zzdevxx/esp32-artnet-dmx/images/10_solder_wire_tin.png

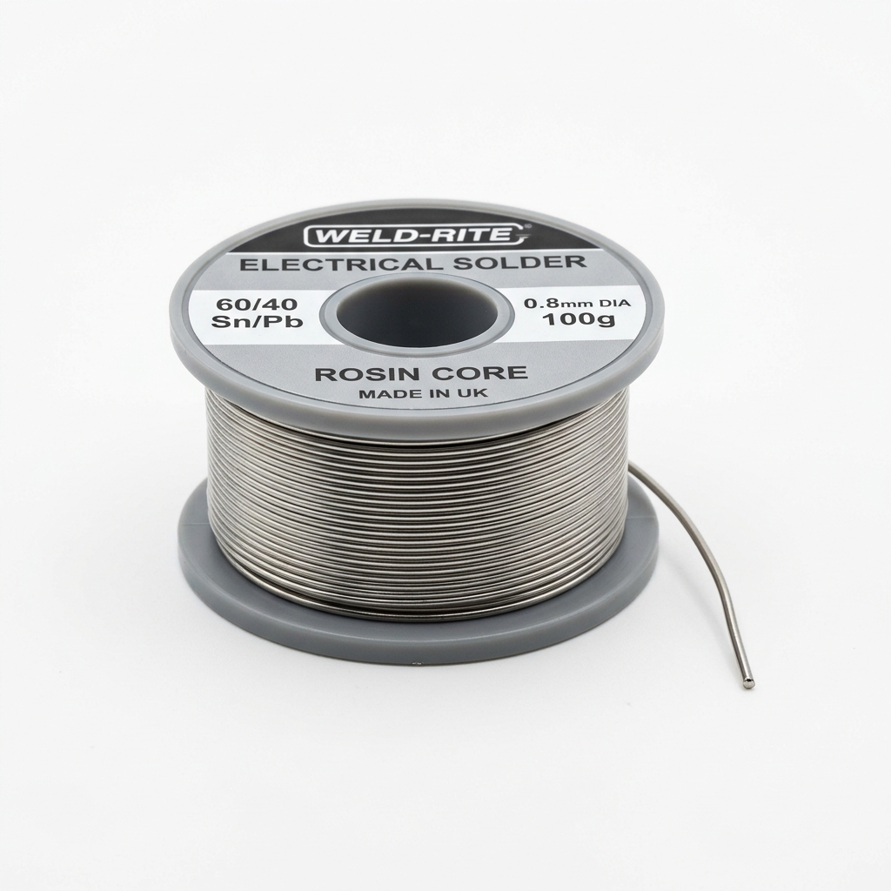
images/10_solder_wire_tin.png
