zzdevxx/esp32-artnet-dmx/RESULT.png

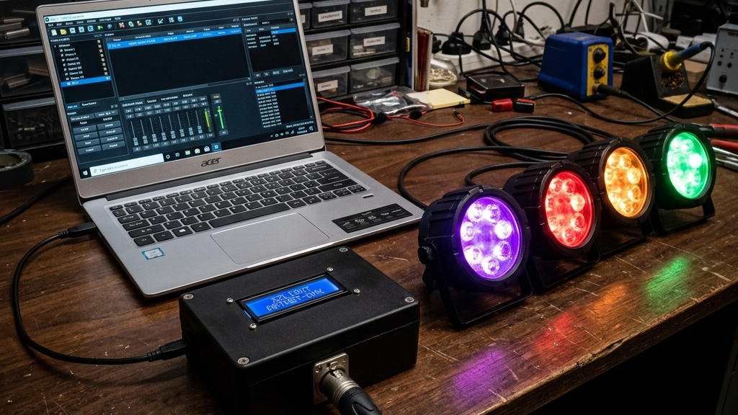
RESULT.png
