zzdevxx/esp32-artnet-dmx/docs/box+rangkaian_01.jpeg

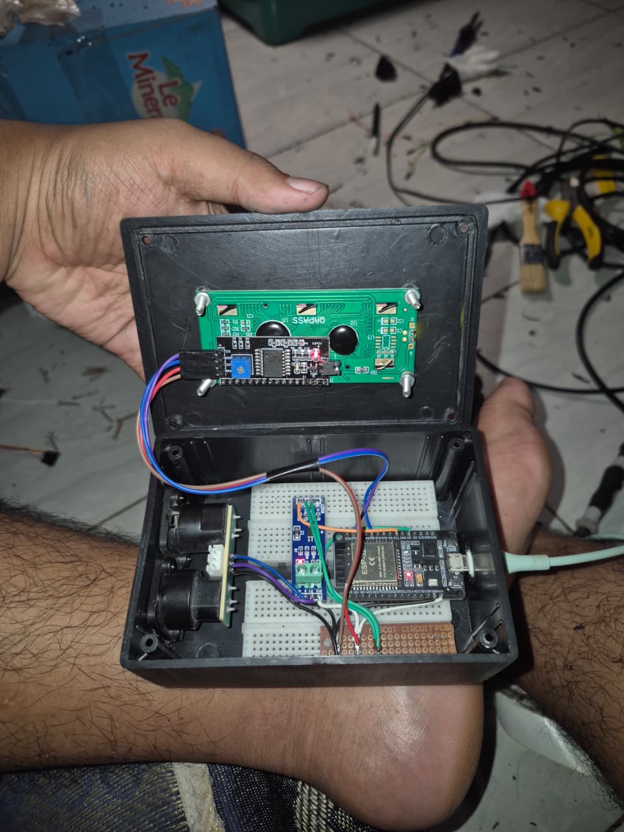
docs/box+rangkaian_01.jpeg
