zzdevxx/esp32-artnet-dmx/docs/box_x4_dibuka.jpeg

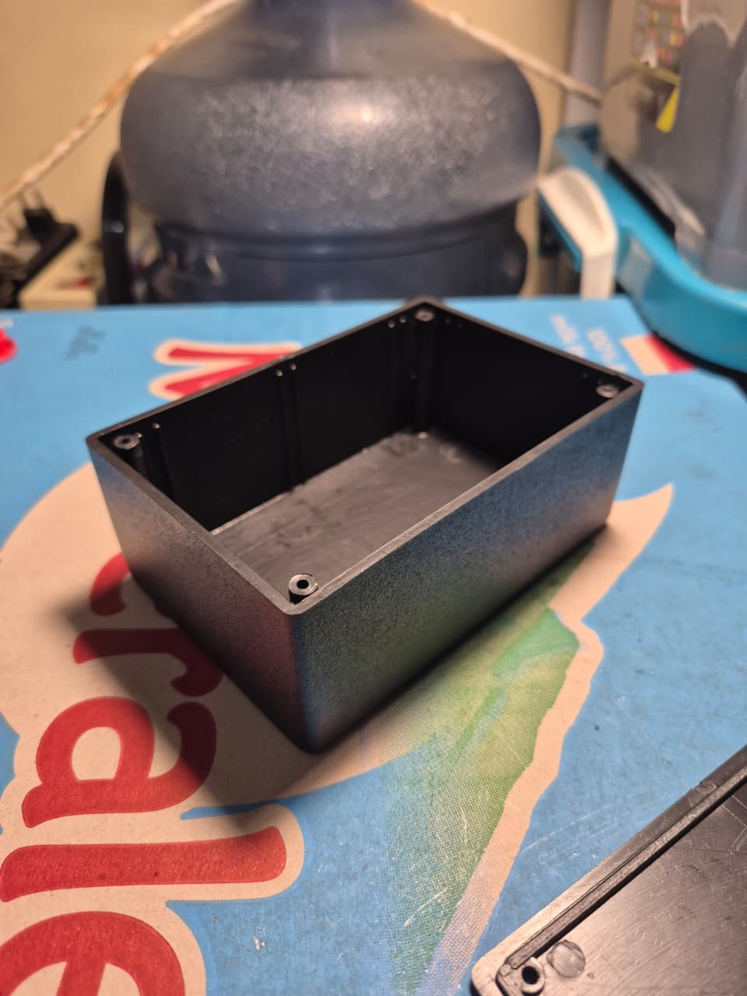
docs/box_x4_dibuka.jpeg
