zzdevxx/esp32-artnet-dmx/docs/box_x4_dilubangi_02.jpeg

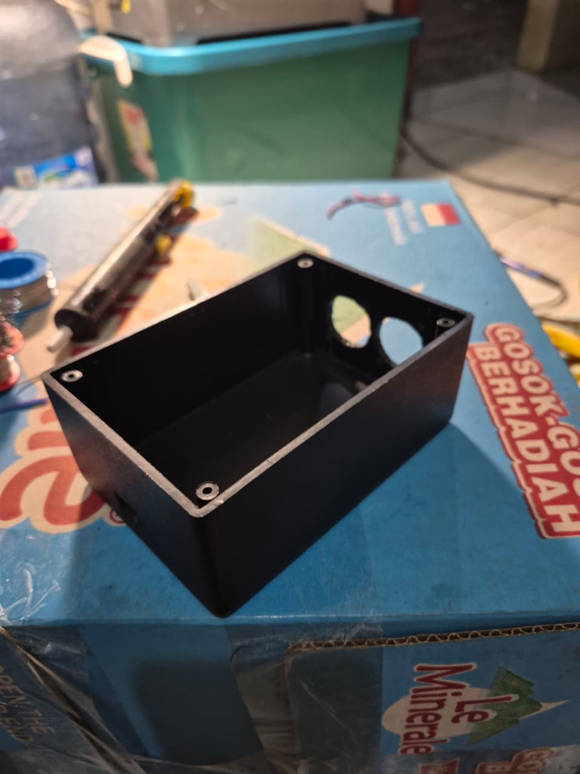
docs/box_x4_dilubangi_02.jpeg
