zzdevxx/esp32-artnet-dmx/docs/box_x4_dipasang_esp32.jpeg

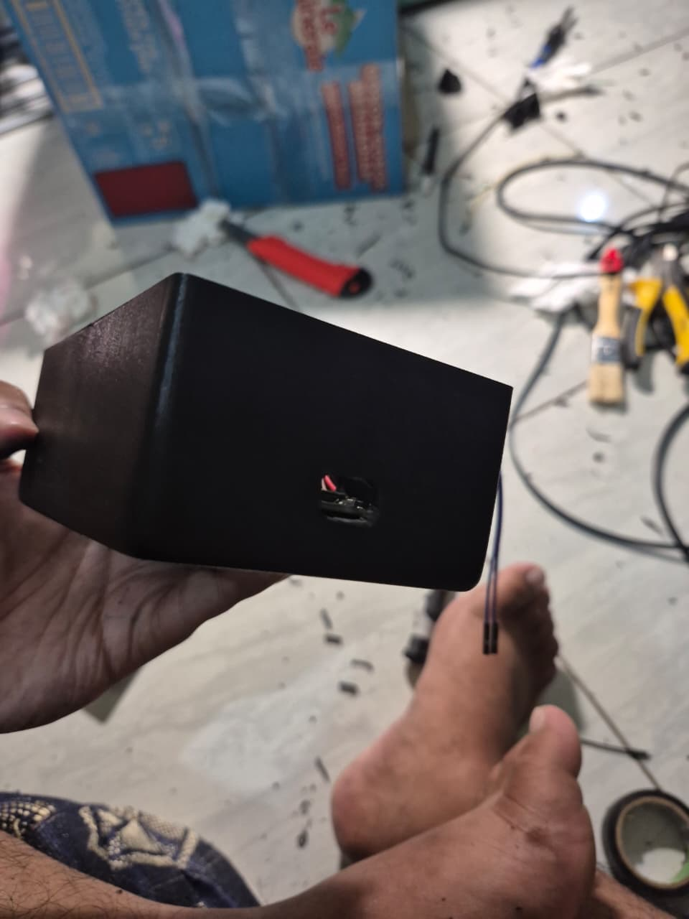
docs/box_x4_dipasang_esp32.jpeg
