zzdevxx/esp32-artnet-dmx/docs/box_x4_dipasang_xlr_01.jpeg

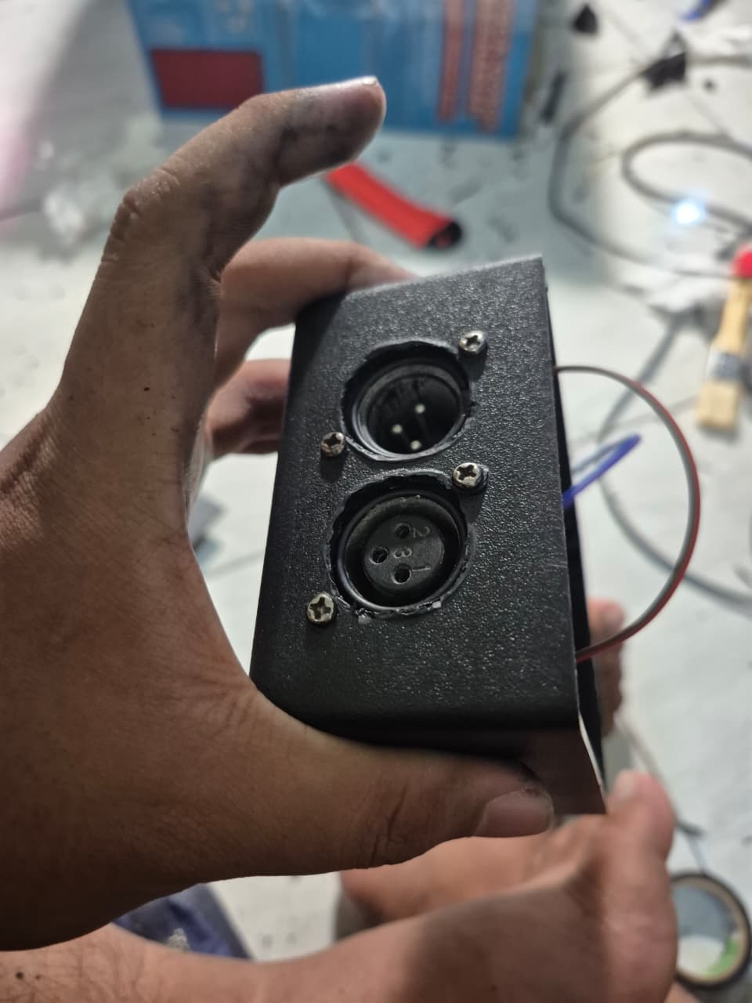
docs/box_x4_dipasang_xlr_01.jpeg
