zzdevxx/esp32-artnet-dmx/docs/box_x4_plus_rangkaian+tutup_01.jpeg

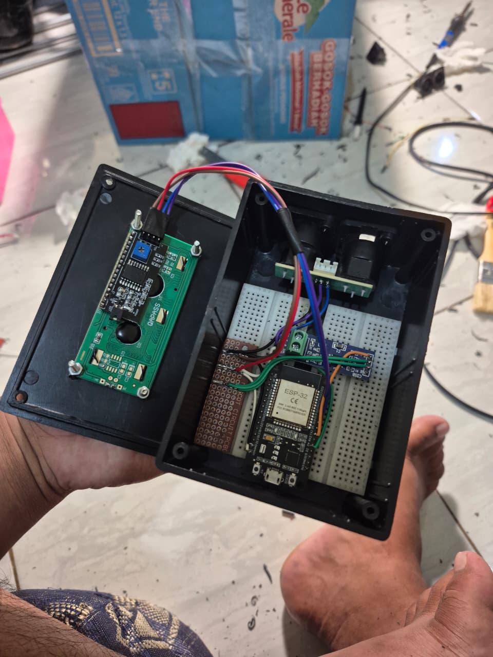
docs/box_x4_plus_rangkaian+tutup_01.jpeg
