zzdevxx/esp32-artnet-dmx/docs/box_x4_plus_rangkaian_01.jpeg

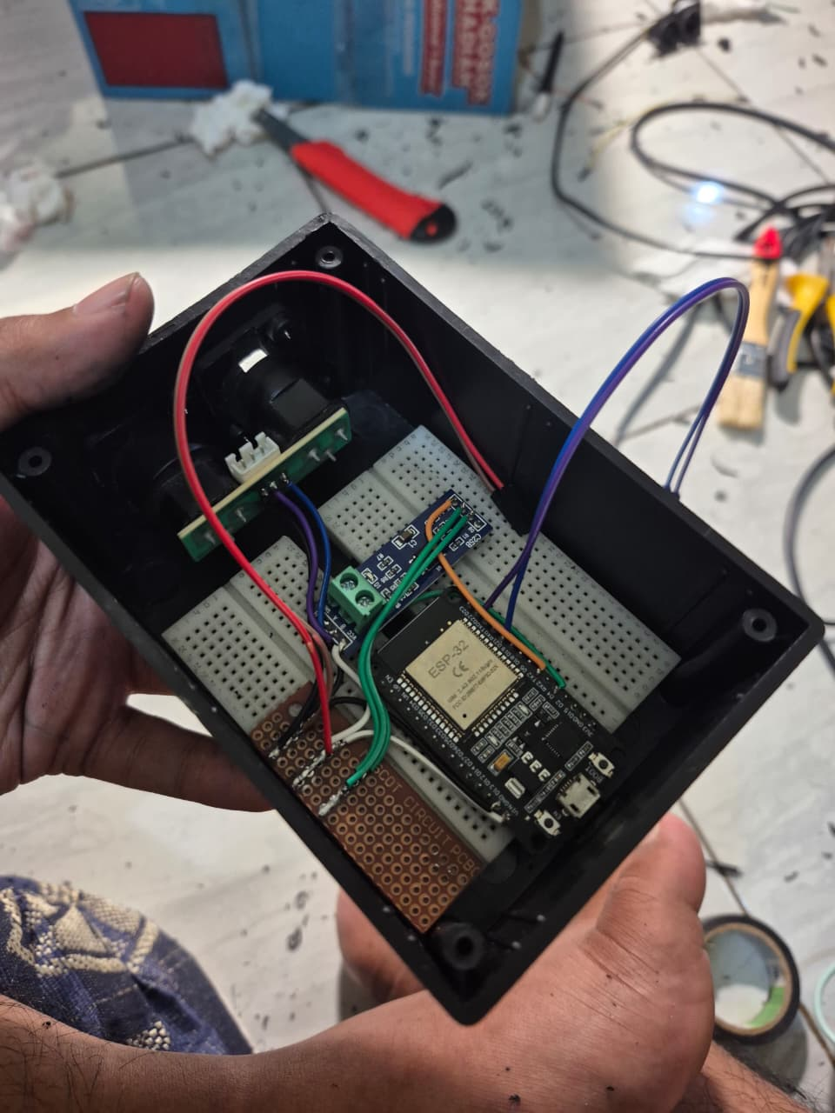
docs/box_x4_plus_rangkaian_01.jpeg
