zzdevxx/esp32-artnet-dmx/docs/box_x4_terbuka.jpeg

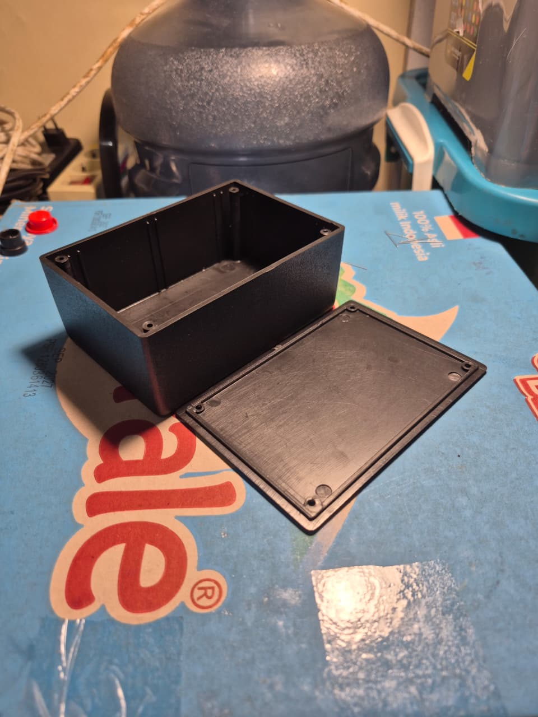
docs/box_x4_terbuka.jpeg
