zzdevxx/esp32-artnet-dmx/docs/box_x4_tertutup.jpeg

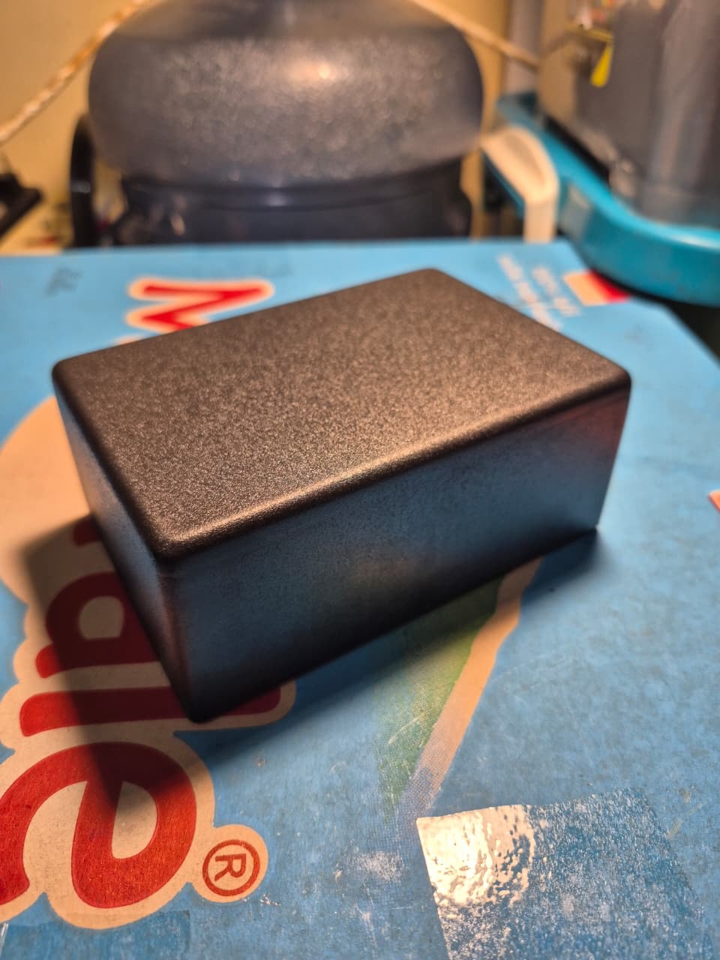
docs/box_x4_tertutup.jpeg
