zzdevxx/esp32-artnet-dmx/docs/breadboard.jpeg

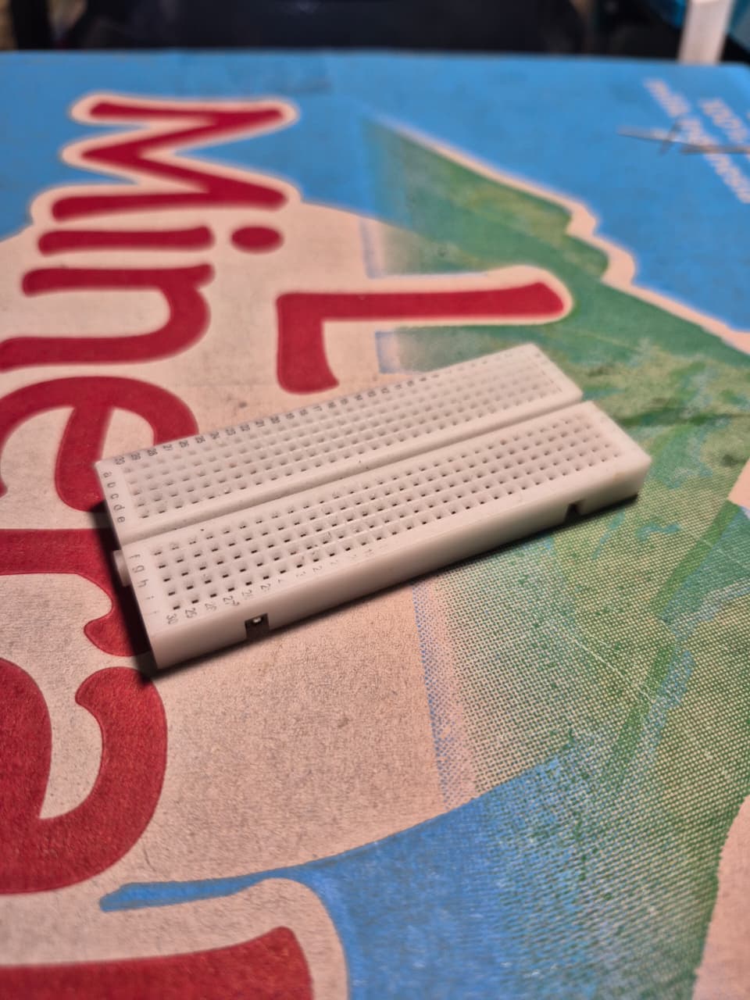
docs/breadboard.jpeg
