zzdevxx/esp32-artnet-dmx/docs/hasil_produk.jpeg

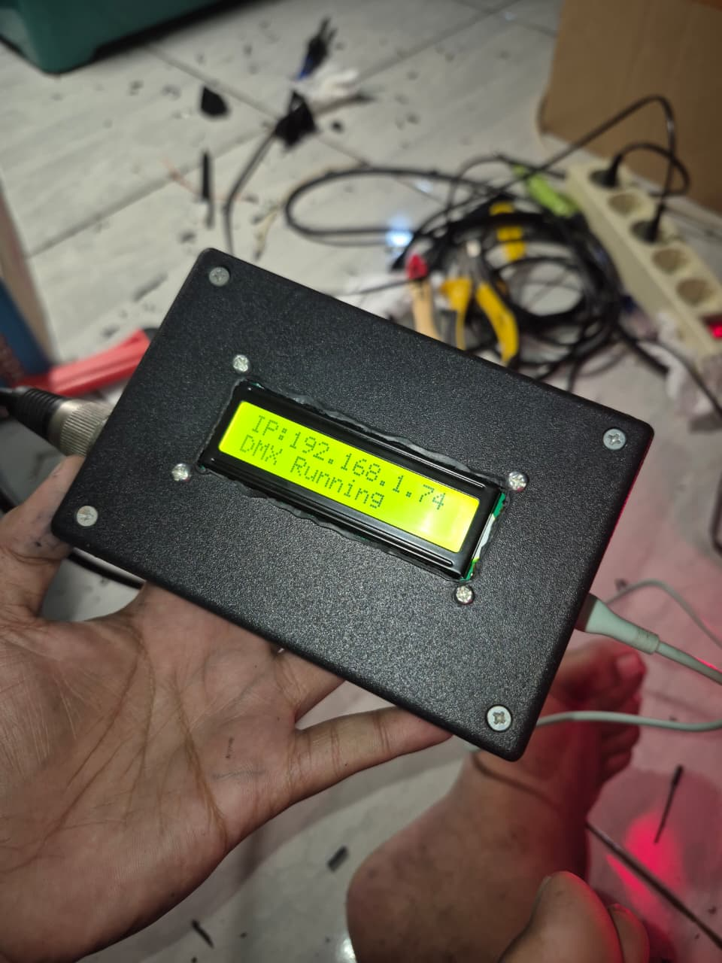
docs/hasil_produk.jpeg
