zzdevxx/esp32-artnet-dmx/docs/rangkaian_01.jpeg

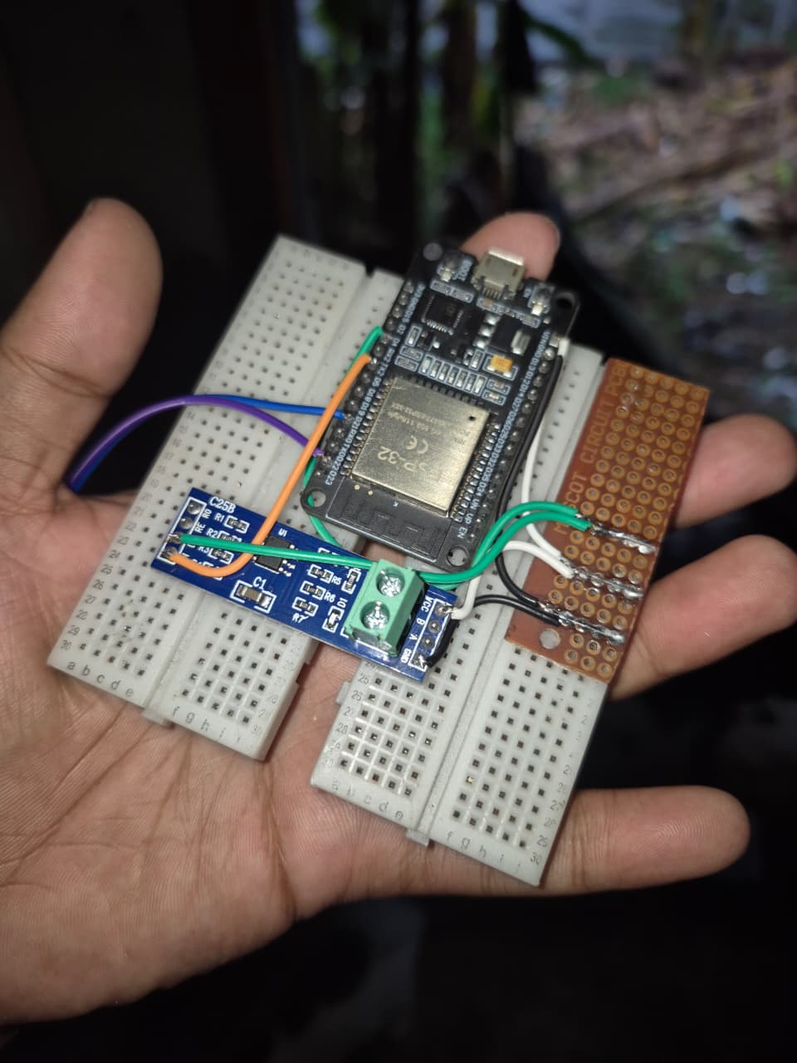
docs/rangkaian_01.jpeg
