zzdevxx/esp32-artnet-dmx/docs/rangkaian_02.jpeg

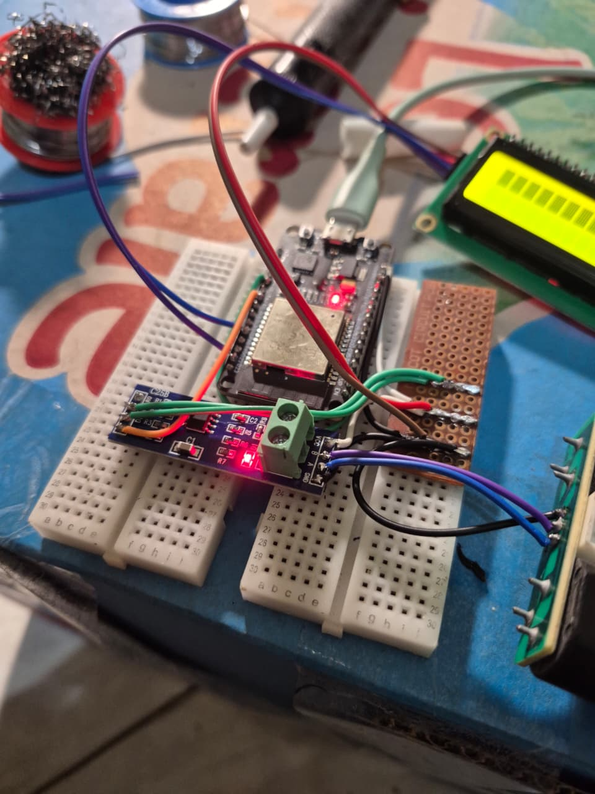
docs/rangkaian_02.jpeg
