zzdevxx/esp32-artnet-dmx/docs/rangkaian_03.jpeg

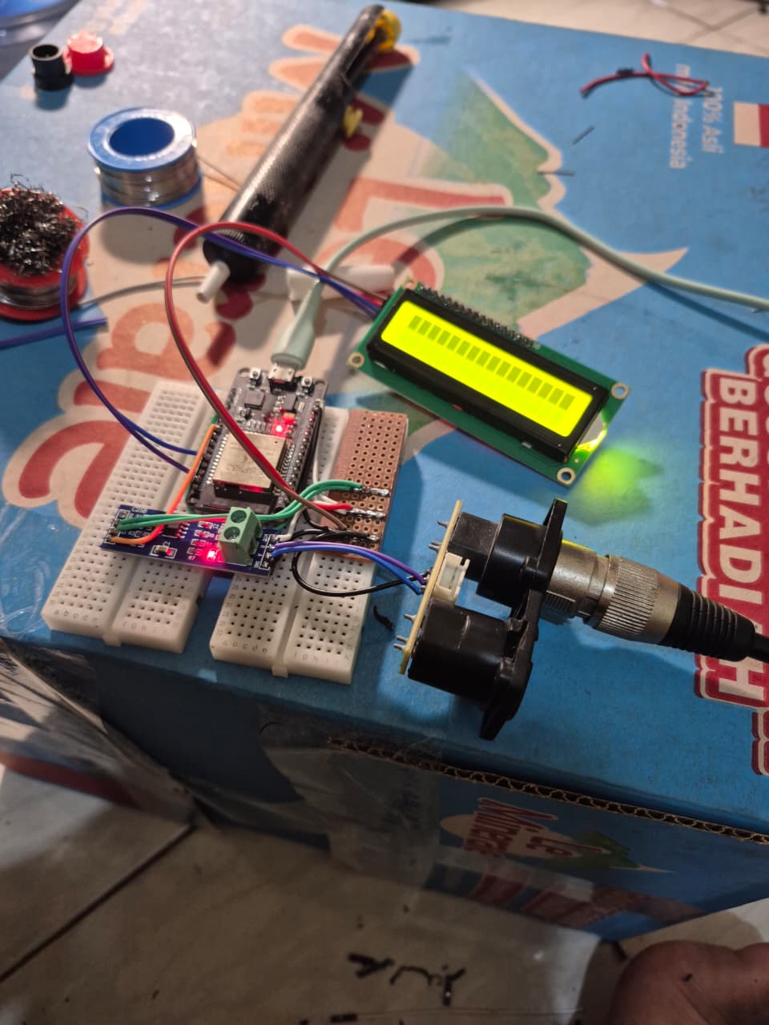
docs/rangkaian_03.jpeg
