zzdevxx/esp32-artnet-dmx/docs/rangkaian_04.jpeg

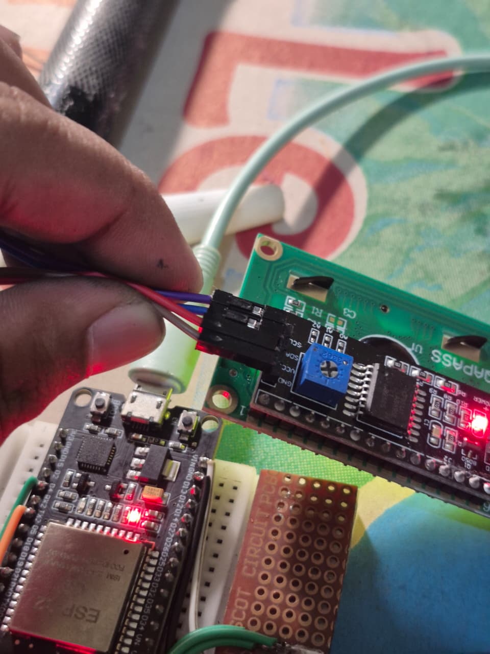
docs/rangkaian_04.jpeg
