zzdevxx/esp32-artnet-dmx/docs/rangkaian_05.jpeg

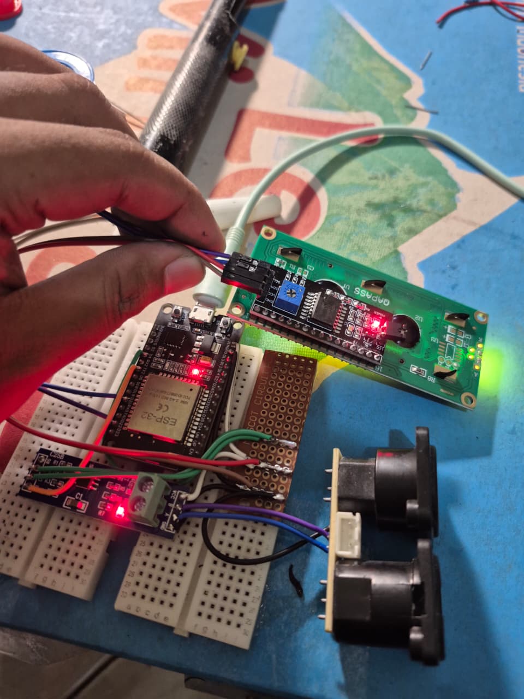
docs/rangkaian_05.jpeg
