zzdevxx/esp32-artnet-dmx/docs/rawboard.jpeg

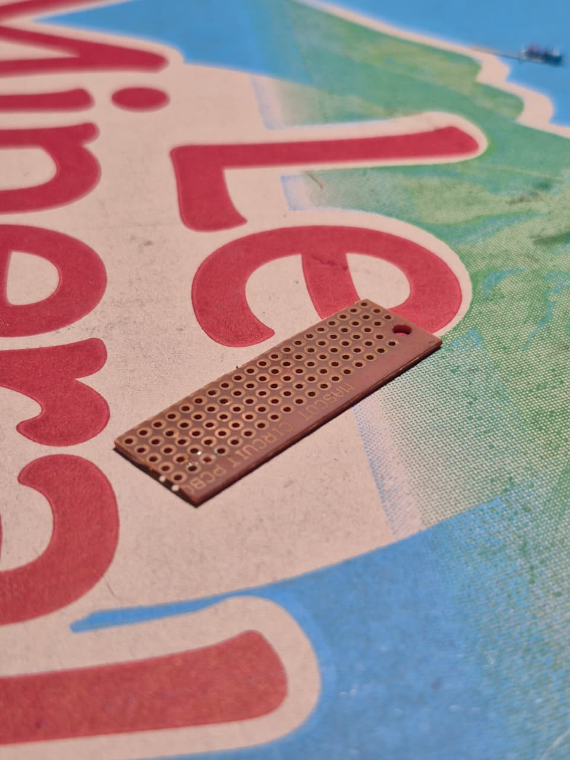
docs/rawboard.jpeg
