zzdevxx/esp32-artnet-dmx/docs/xlr_socket_back.jpeg

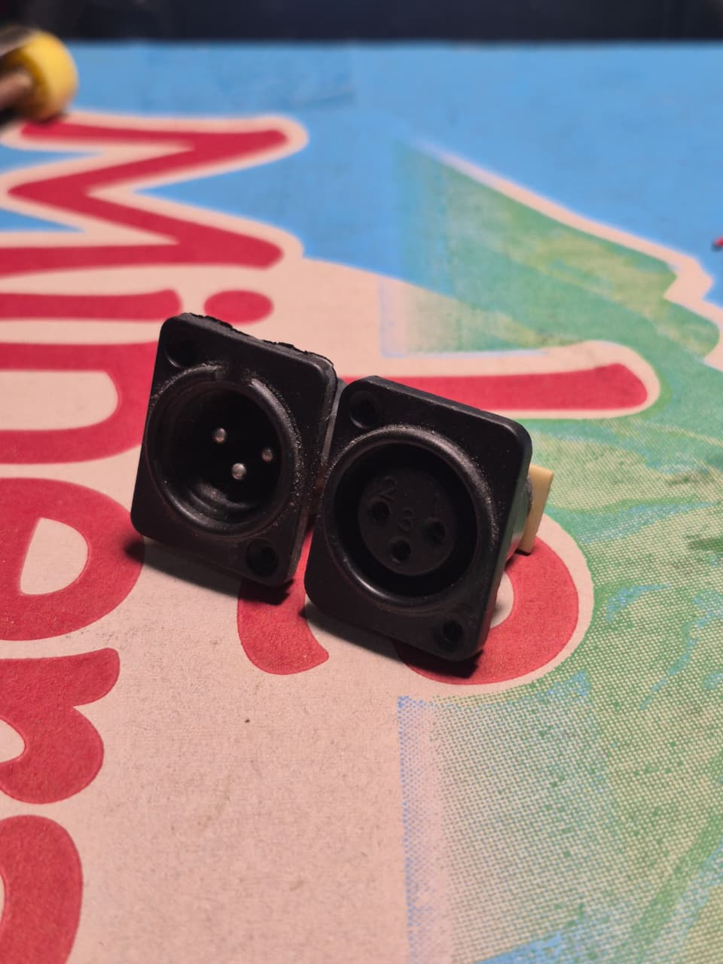
docs/xlr_socket_back.jpeg
