zzdevxx/esp32-artnet-dmx/docs/xlr_socket_rear.jpeg

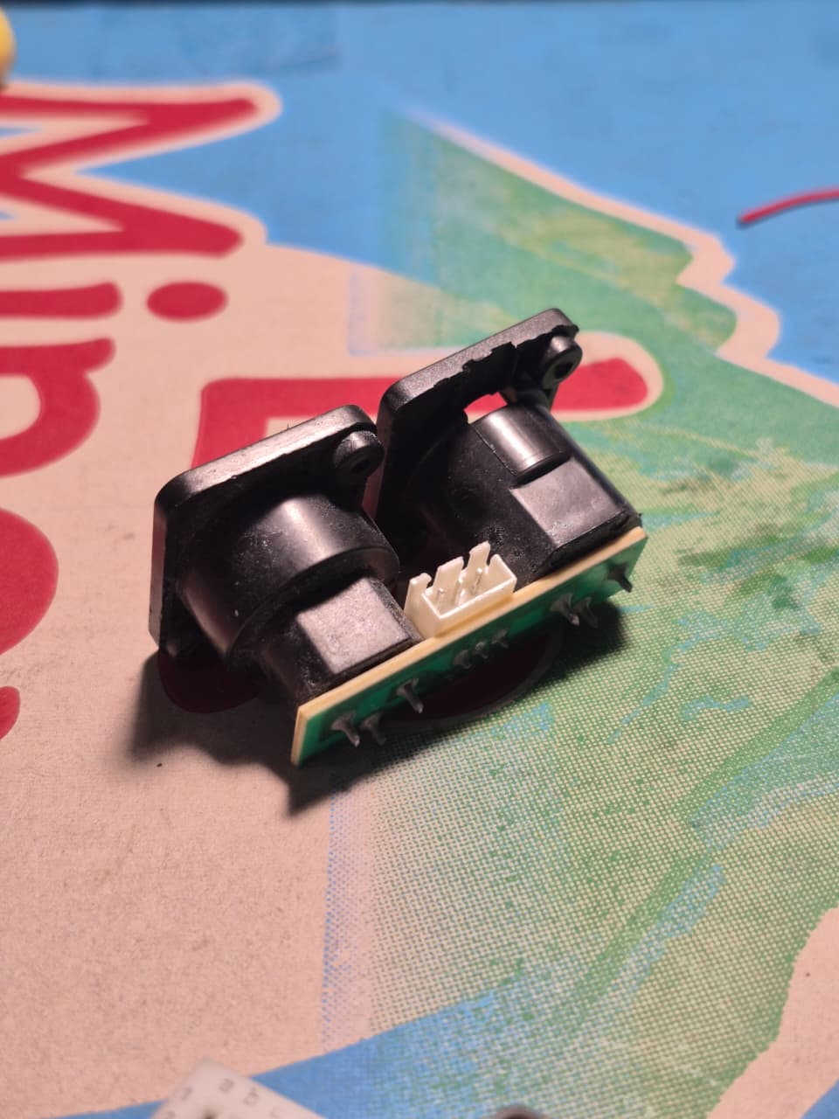
docs/xlr_socket_rear.jpeg
