zzdevxx/esp32-artnet-dmx/images/07_pin_headers_male_female.png

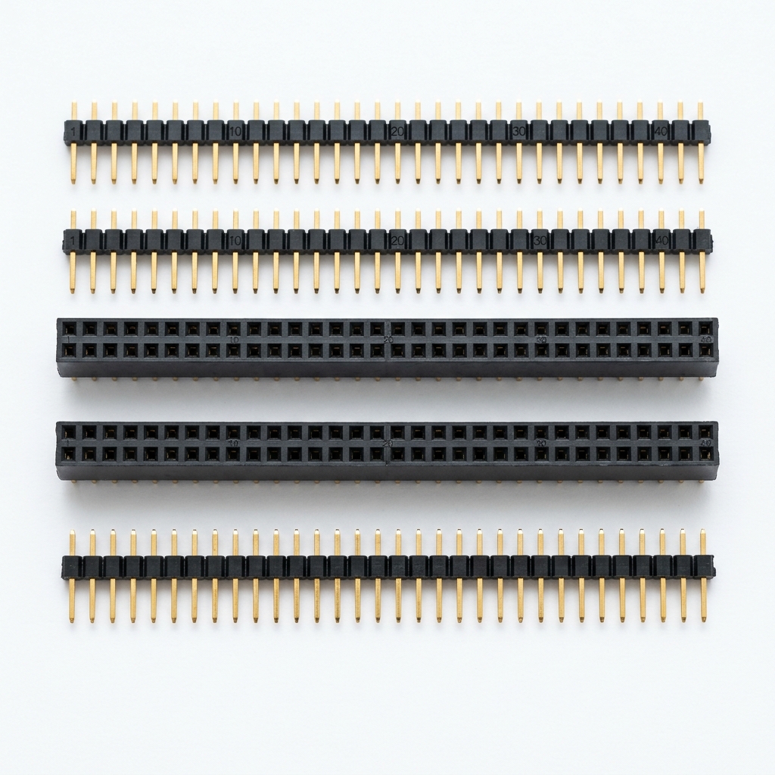
images/07_pin_headers_male_female.png
