zzdevxx/esp32-artnet-dmx/images/08_jumper_wires.png

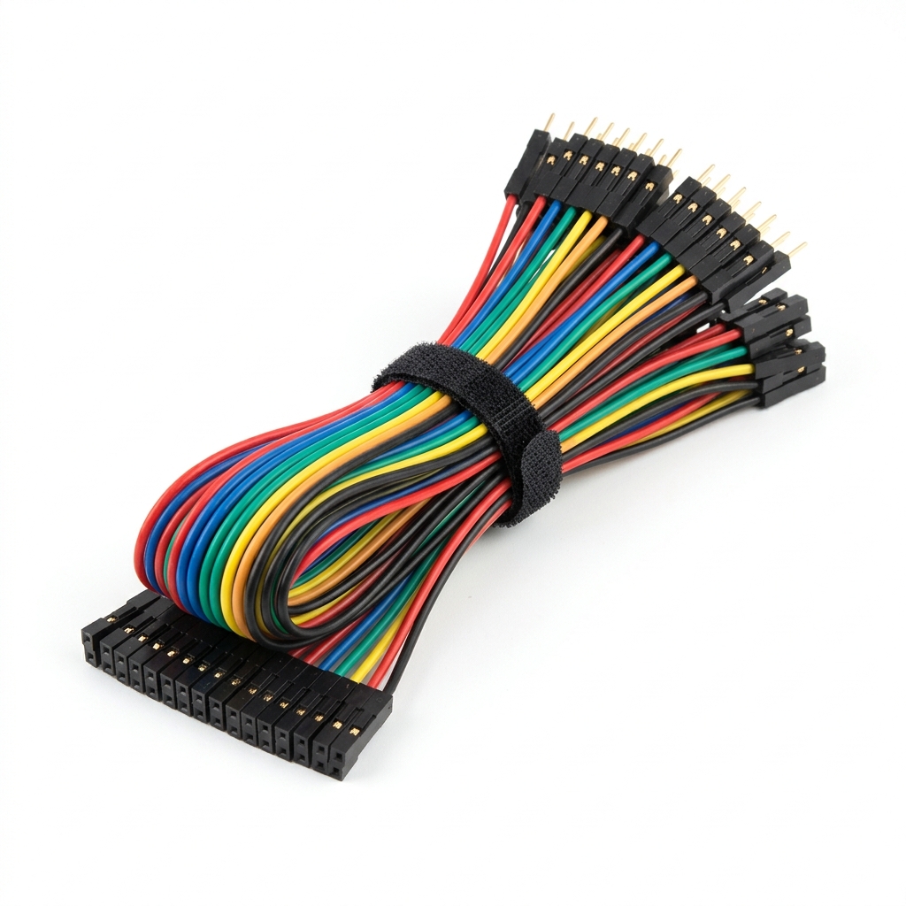
images/08_jumper_wires.png
