zzdevxx/esp32-artnet-dmx/images/09_usb_cable.png

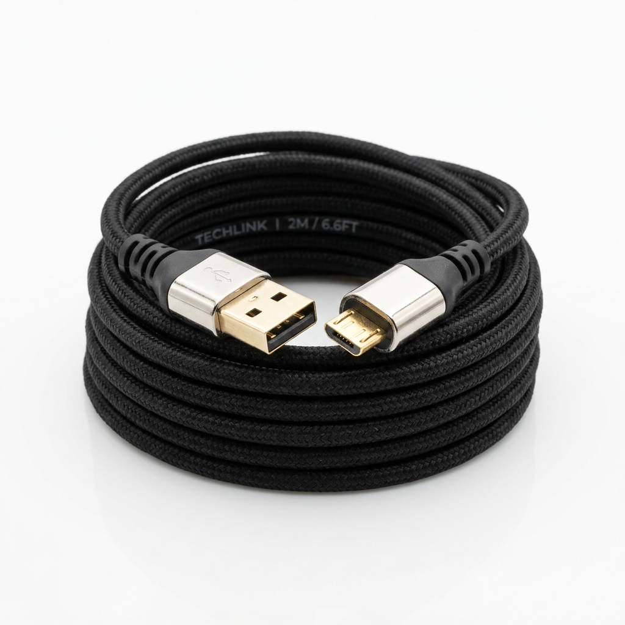
images/09_usb_cable.png
