zzdevxx/esp32-artnet-dmx/images/13_digital_multimeter.png

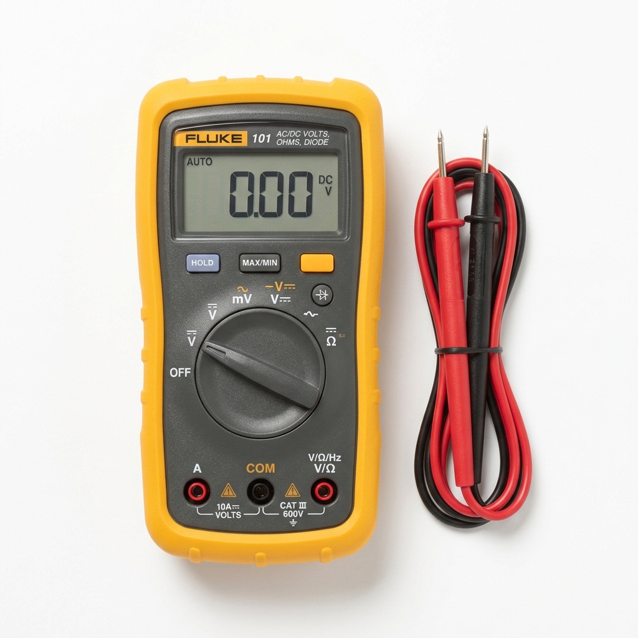
images/13_digital_multimeter.png
