zzdevxx/esp32-artnet-dmx/images/14_breadboard_830_points.png

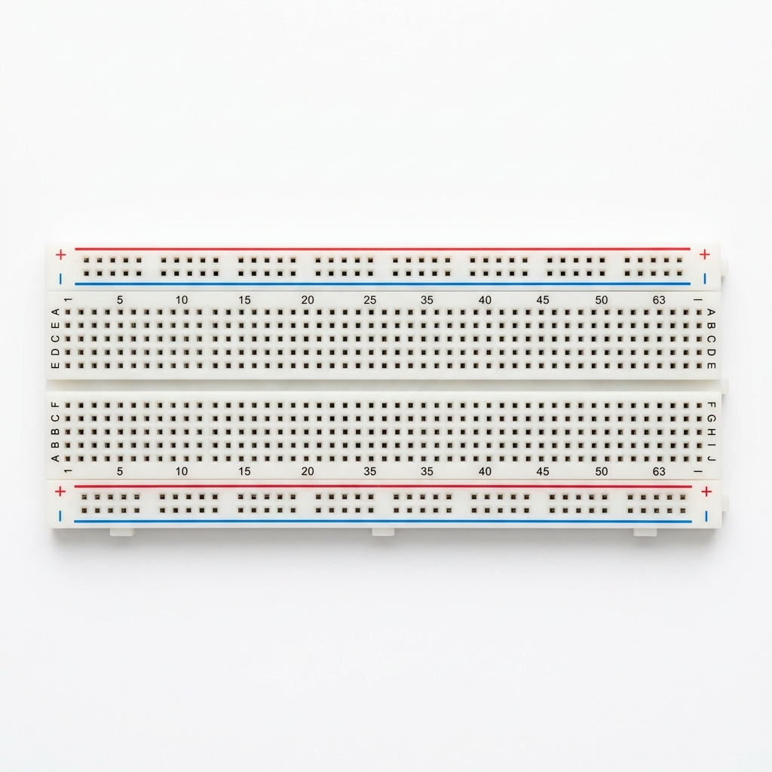
images/14_breadboard_830_points.png
