zzdevxx/esp32-artnet-dmx/images/15_side_wire_cutters.png

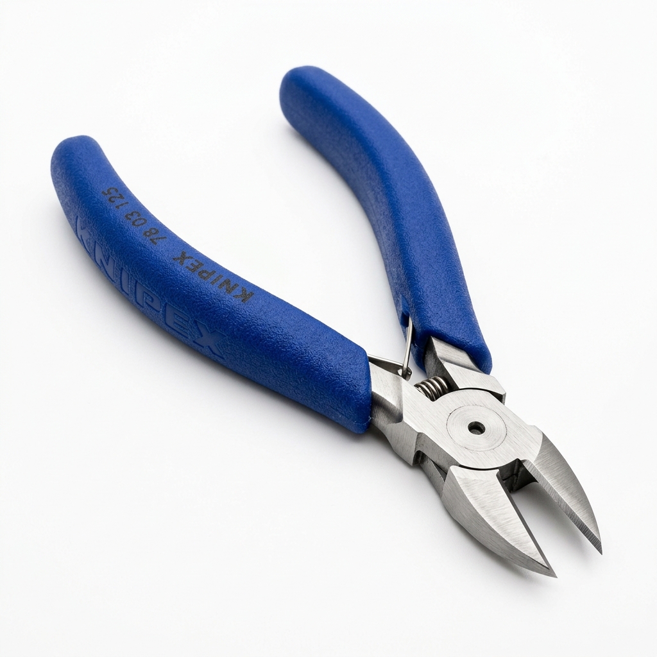
images/15_side_wire_cutters.png
