zzdevxx/esp32-artnet-dmx/images/17_precision_screwdrivers.png

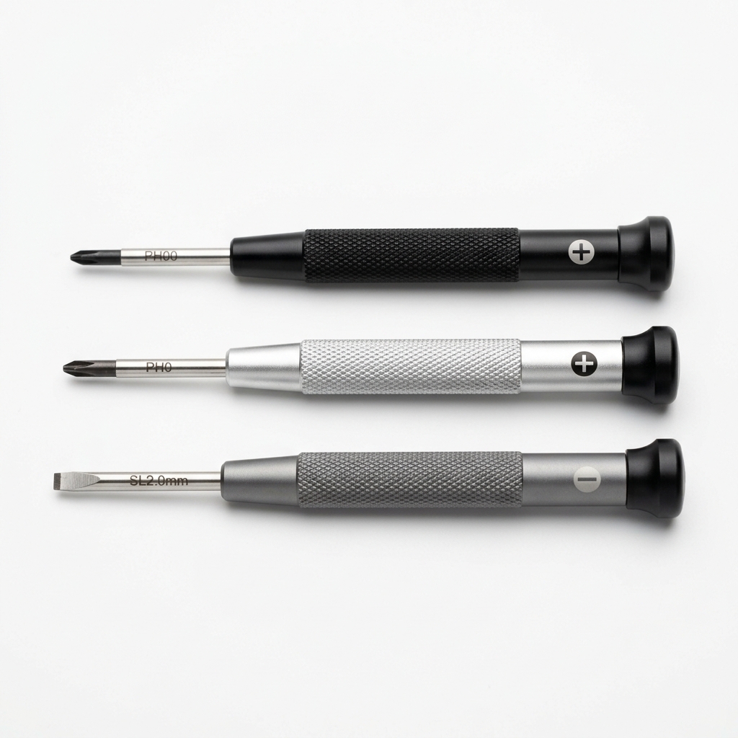
images/17_precision_screwdrivers.png
