zzdevxx/esp32-artnet-dmx/images/18_dmx_cable_xlr_3m.png

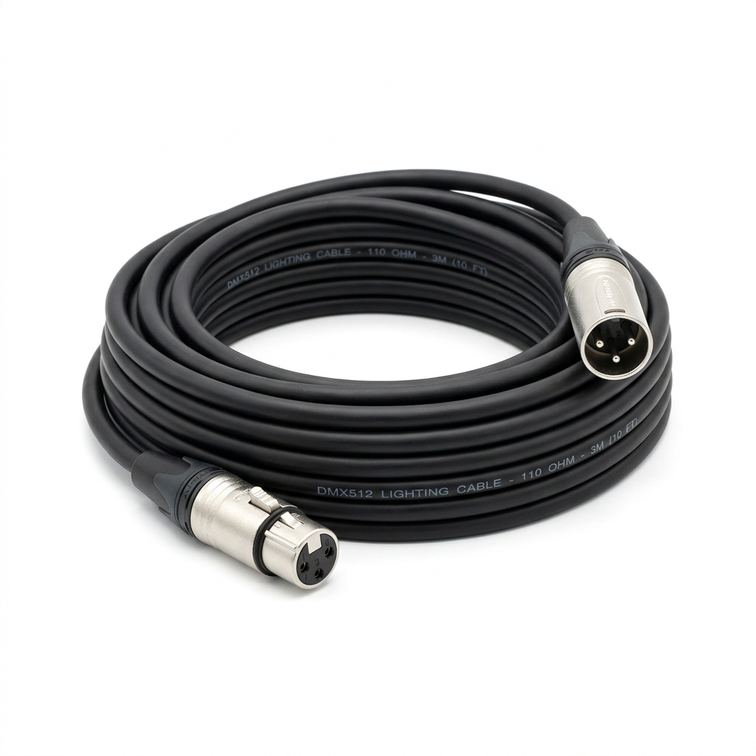
images/18_dmx_cable_xlr_3m.png
