zzdevxx/esp32-artnet-dmx/images/19_laptop_acer_swift_3.png

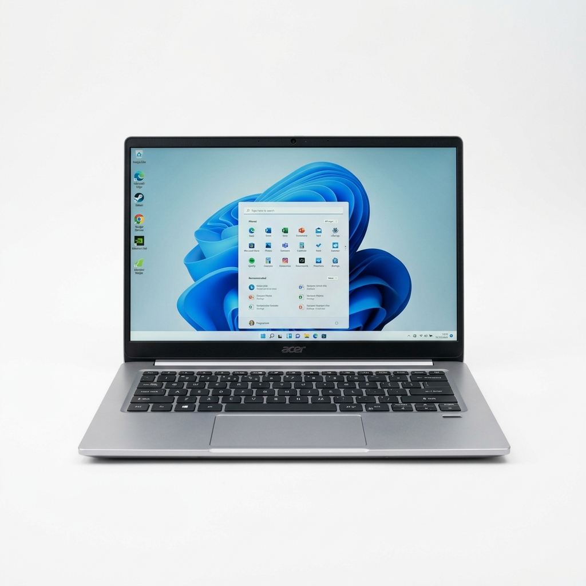
images/19_laptop_acer_swift_3.png
