zzdevxx/esp32-artnet-dmx/images/20_parled_54_leds.png

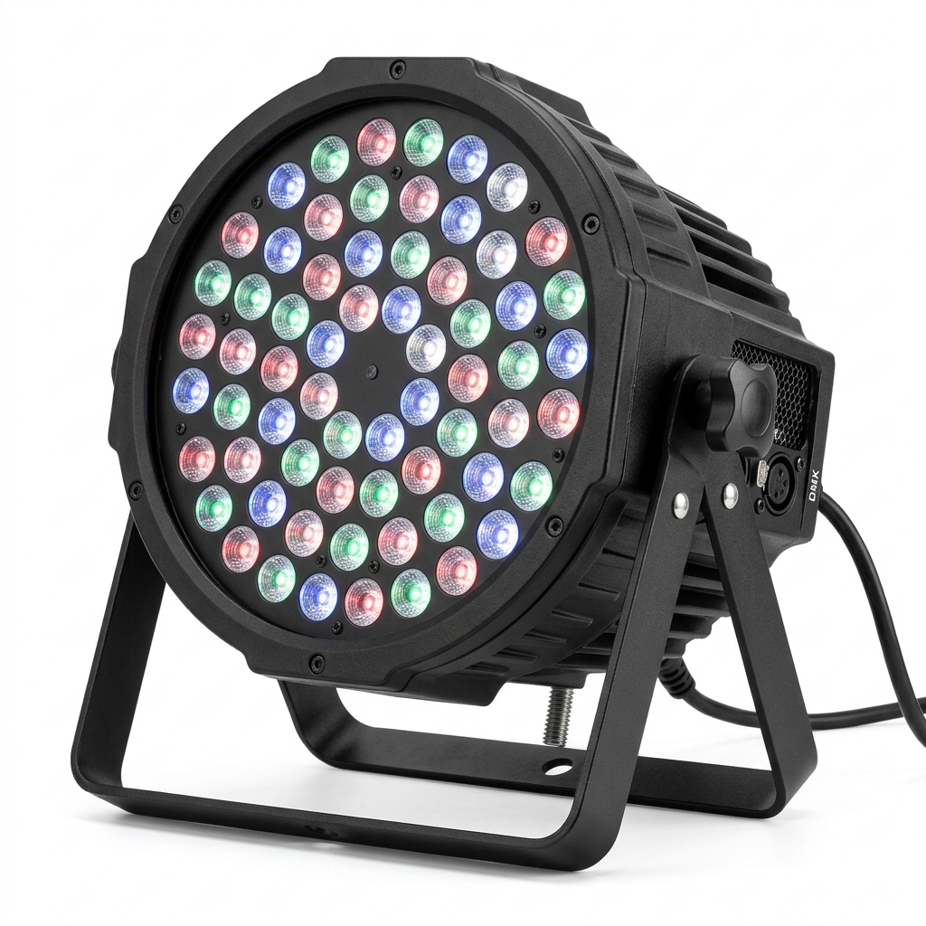
images/20_parled_54_leds.png
