zzdevxx/esp32-artnet-dmx/images/22_craft_scissors.png

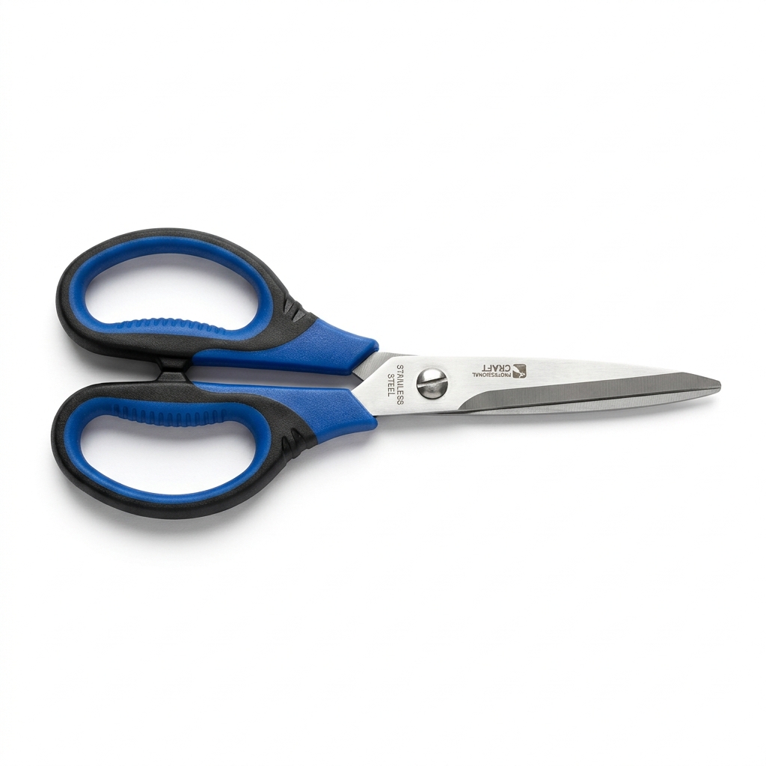
images/22_craft_scissors.png
