zzdevxx/esp32-artnet-dmx/schematics/01_system_block_diagram.png

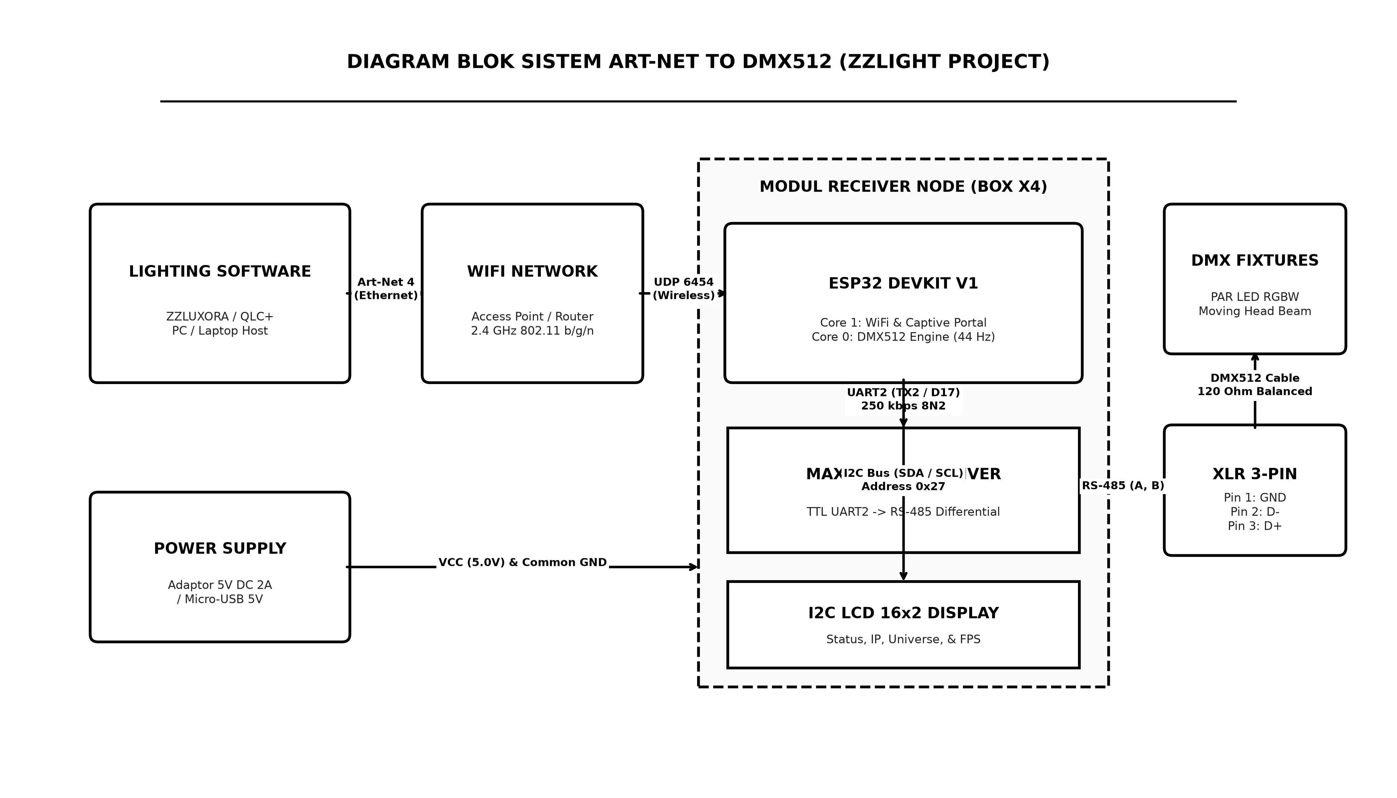
schematics/01_system_block_diagram.png
