zzdevxx/esp32-artnet-dmx/schematics/03_dmx512_timing_diagram.png

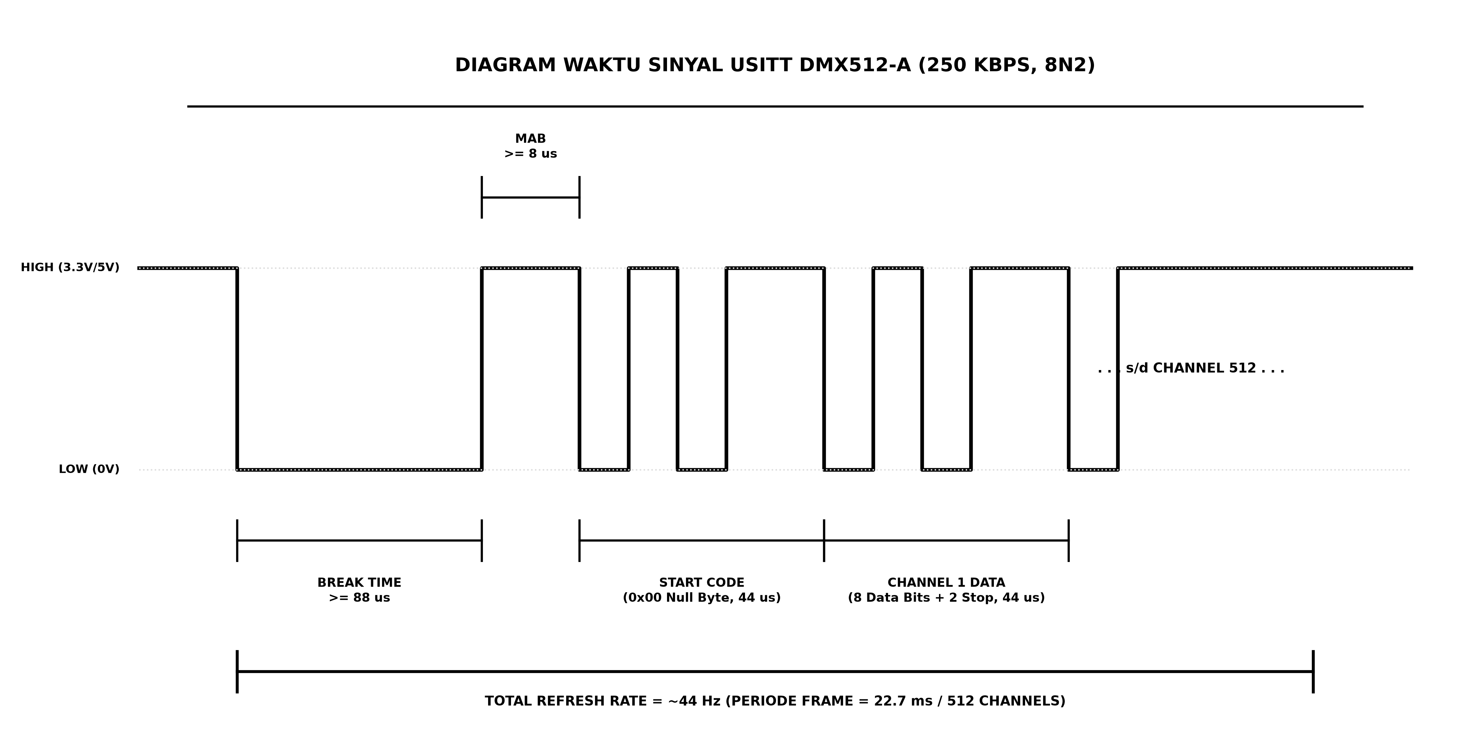
schematics/03_dmx512_timing_diagram.png
