zzdevxx/esp32-artnet-dmx/schematics/04_freertos_dual_core_architecture.png

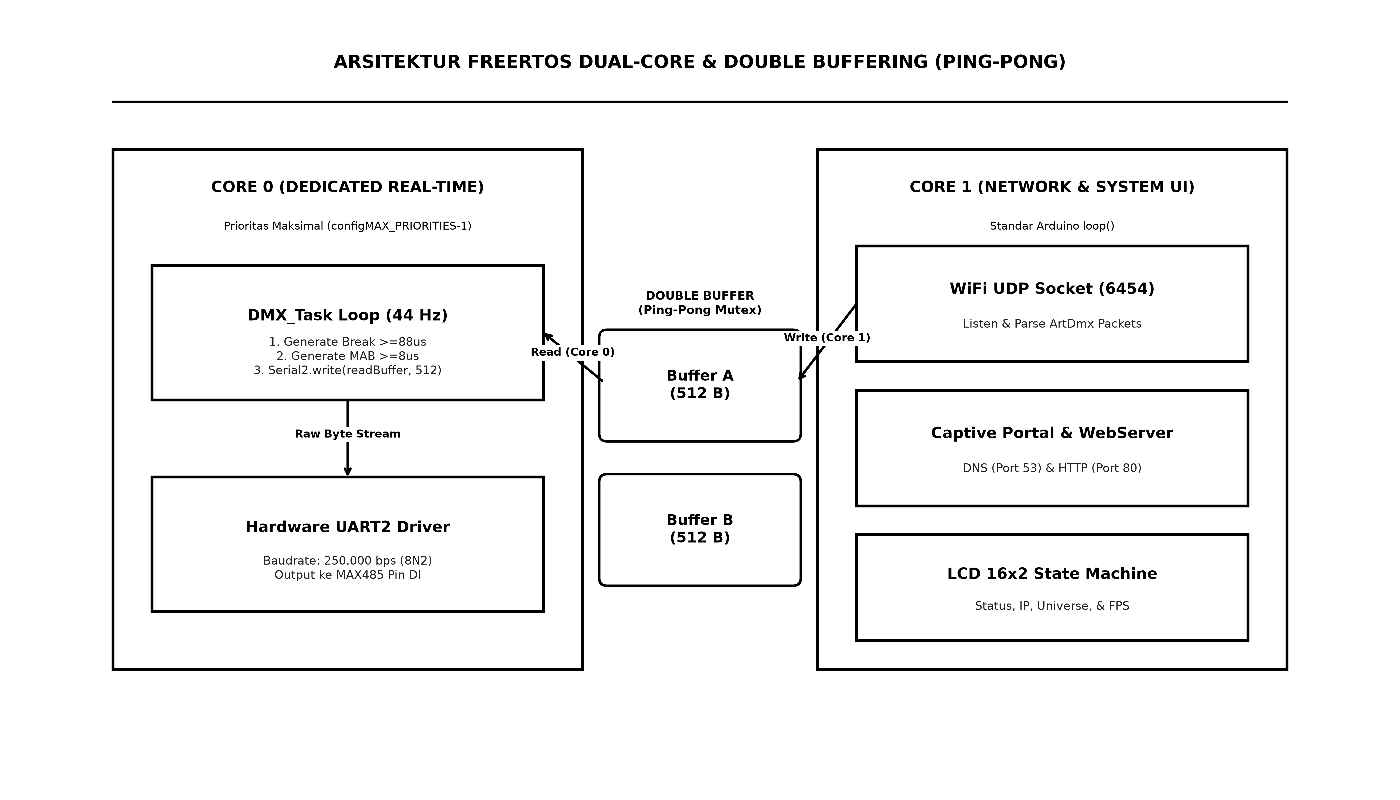
schematics/04_freertos_dual_core_architecture.png
