zzdevxx/esp32-artnet-dmx/schematics/05_lcd16x2_state_machine_flowchart.png

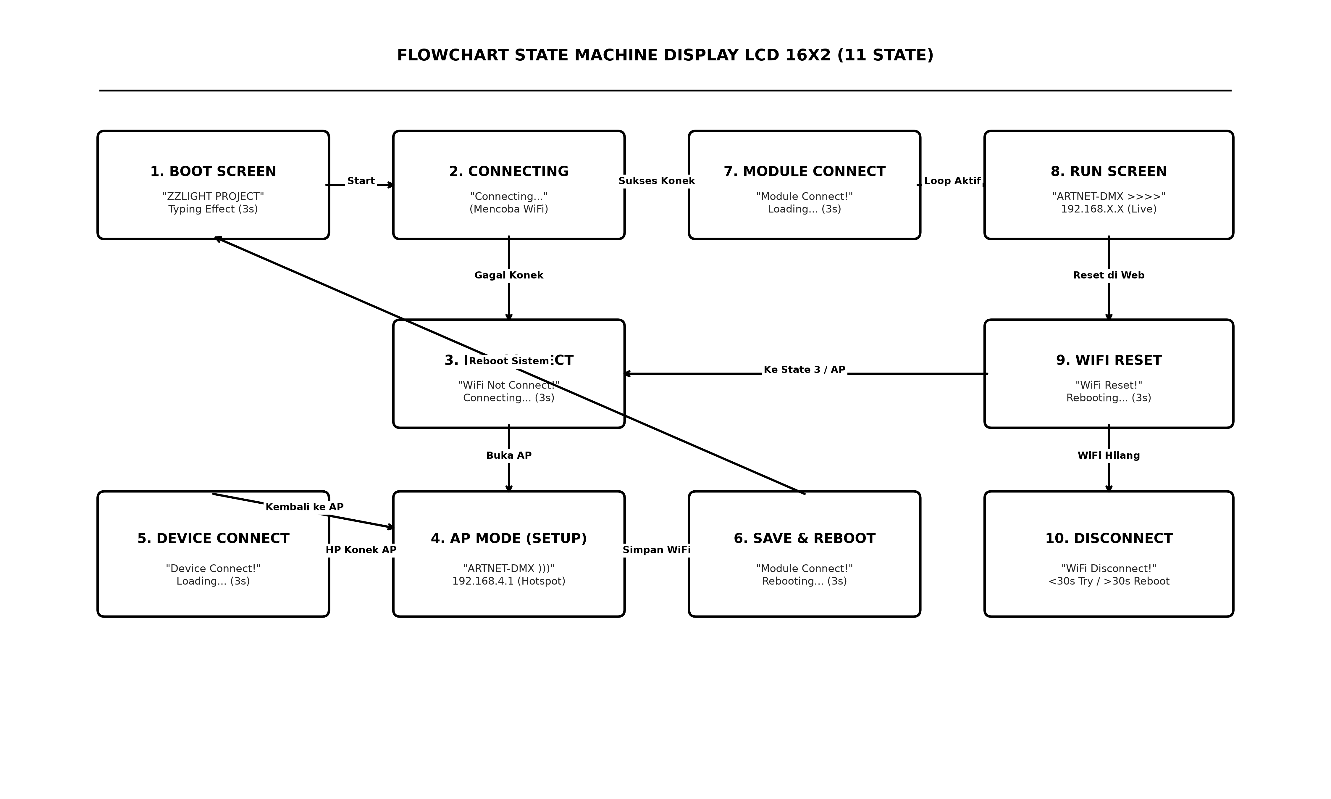
schematics/05_lcd16x2_state_machine_flowchart.png
