zzdevxx/esp32-artnet-dmx/images/11_soldering_iron.png

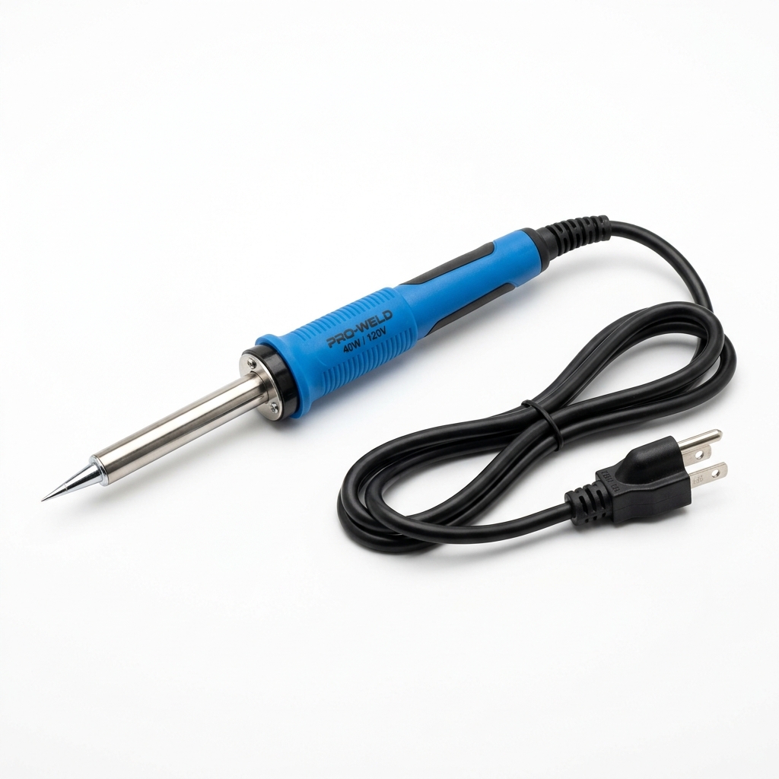
images/11_soldering_iron.png
