zzdevxx/esp32-artnet-dmx/images/12_desoldering_pump.png

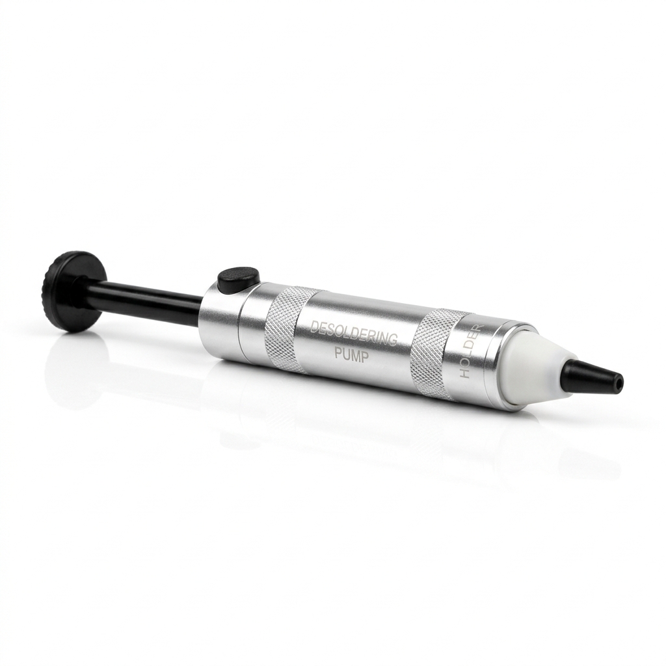
images/12_desoldering_pump.png
