zzdevxx/esp32-artnet-dmx/images/16_step_drill_bit.png

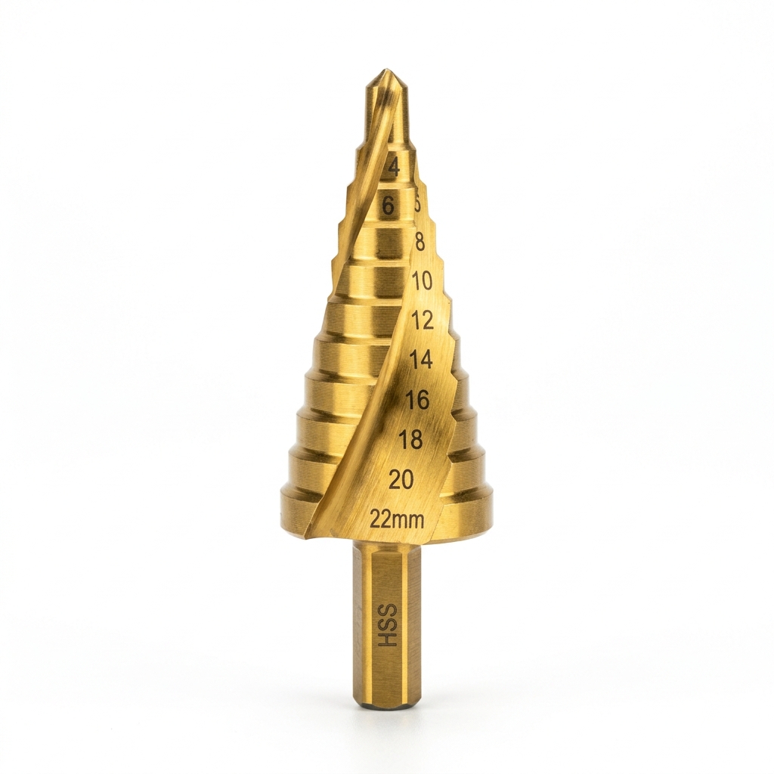
images/16_step_drill_bit.png
