zzdevxx/esp32-artnet-dmx/images/21_soldering_flux_paste.png

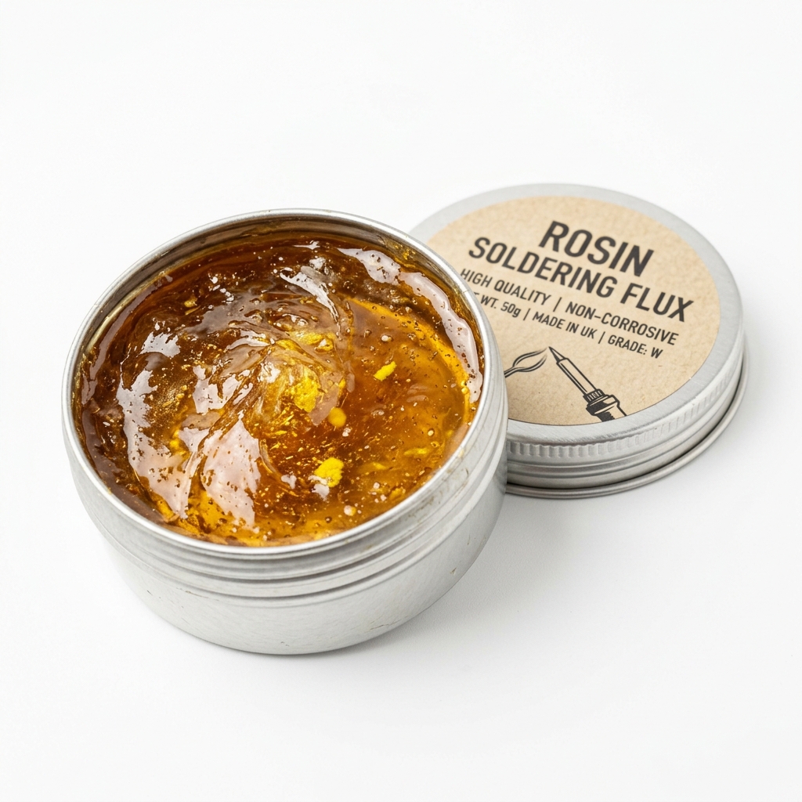
images/21_soldering_flux_paste.png
