zzdevxx/esp32-artnet-dmx/schematics/02_esp32_max485_wiring_schematic.png

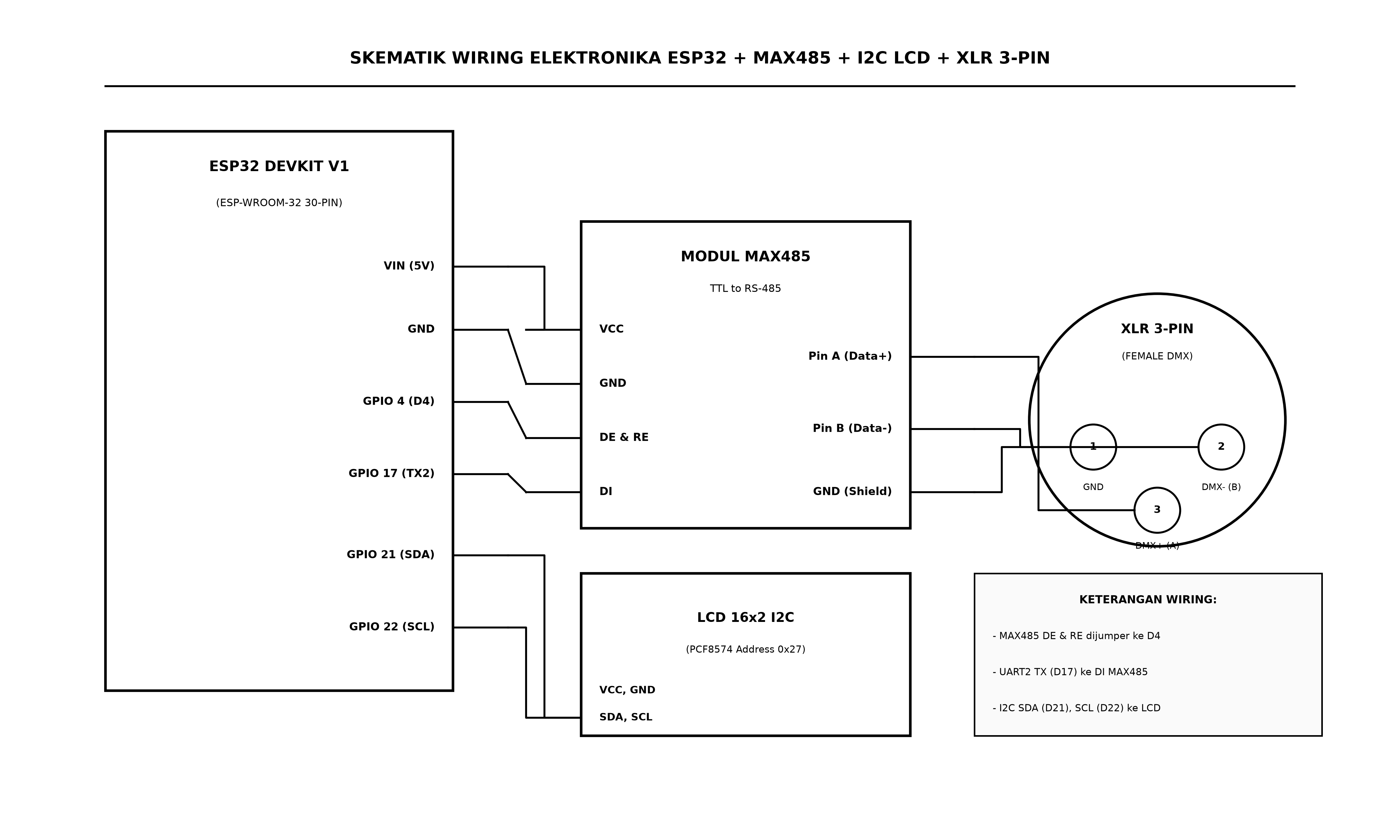
schematics/02_esp32_max485_wiring_schematic.png
