zzdevxx/esp32-artnet-dmx/(commit log)

2026-08-20 feat: initial release of ESP32 Art-Net to DMX512 module tutorial, firmware, schematic references, documentation photos, and PDF report
2026-08-20 chore: remove unused schematics images
2026-08-20 feat: complete visual assets with 22 catalog images, 5 schematics, and perfected 16:9 RESULT.png
2026-08-20 style: update RESULT.png with authentic Box X4 physical enclosure and 16:9 widescreen
2026-08-20 chore: update folder name and path references to esp32-artnet-dmx
2026-08-20 temp rename for case fix
2026-11-11 feat(firmware): upgrade to v5.1.0 hardened production master with lock-free triple buffering
    - Implement lock-free triple buffering eliminating frame tearing and data races
    - Implement Art-Net 4 compliance (15-bit Port-Address, ProtVer >= 14, length validation)
    - Add ArtPoll auto-discovery engine with OpCode 0x2100 ArtPollReply
    - Add UDP socket drain loop and disable Wi-Fi modem sleep (<3ms latency)
    - Protect I2C bus with Wire.setTimeOut(25) against stage vibration freeze
    - Add background reconnect saga in AP mode and block /scan in RUN mode
    - Update documentation and hardware PRD
    [artnet_dmx_final.ino]
2026-11-11 refactor(firmware): optimize Arduino portable delay, clean boot LCD sequence, and CORS headers
    - Replace esp_rom_delay_us with portable delayMicroseconds(10) eliminating esp_rom_sys.h dependency
    - Clarify sequential LCD boot display in setup() (ZZLIGHT PROJECT -> Connecting/AP Mode)
    - Add Access-Control-Allow-Origin headers to WebServer status endpoints
    - Ensure ArtPollReply is addressed strictly to Art-Net port 6454
    [artnet_dmx_final.ino]
2026-11-11 refactor(firmware): upgrade to v5.2.0 hardened production master with single-pass routes and verified ArtPollReply
    - Fix ArtPollReply byte offsets according to official Art-Net 4 specification
    - Implement single-pass state-aware web route registration to prevent route duplication
    - Add continuous status polling in background AP reconnect saga
    - Add guaranteed vTaskDelay(1) in DMXCoreTask to feed Core 0 TWDT watchdog
    - Cast signed char to uint8_t in escapeJsonString preventing buffer truncation
    - Increase status JSON buffer to 512 bytes
    - Add tabular numerals and 5-state interactive contract to web monitor
    - Create matching artnet_dmx_final/ sketch directory for Arduino IDE double-click suppo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
    [artnet_dmx_final.ino]
2026-11-11 feat(firmware): restore signature wave animations, add password toggle, and enforce full English UI
    - Restore signature parenthesis wave animation ())))) in AP mode
    - Restore signature arrow wave animation (>>>>>) in RUN mode
    - Integrate seamless device connection detection into AP status row
    - Add SHOW/HIDE password toggle button to web setup portal
    - Enforce 100% full English chrome across all LCD screens and web monitor
2026-11-12 feat(firmware): standardize LCD station notification to Device Connect!
    Align station detection notification on 16x2 LCD Row 1 with Module Connect!
    and WiFi Disconnect! for 100% syntactic and typographic consistency.
2026-11-12 feat(firmware): finalize 100% consistent LCD status notifications
    - Standardize S_WIFI_ERR to WiFi Not Set! (16 chars with !)
    - Standardize S_WIFI_FAIL to WiFi Failed! (16 chars with !)
    - Integrate S_WIFI_RST and S_MOD_CONN1 LCD screens before reboot in WebServer
    [artnet_dmx_final.ino]
2026-11-12 feat(firmware): harmonize universal web button contracts and two-way setup navigation
    - Unify universal .btn classes across AP_HTML and RUN_HTML with full 5-state contract
    - Add input focus outline styling and polished toggle password button transitions
    - Keep Network Setup link permanently accessible in RUN mode for bidirectional navigation
    - Update post-reset redirect target to AP mode IP 192.168.4.1
    [artnet_dmx_final.ino]
2026-11-12 style(firmware): eradicate decorative banner comments and polish native font fallback
    - Eliminate AI decorative dash banners (// ---) across all firmware sections
    - Use native system font stack with offline fallback (-apple-system, Segoe UI, Roboto)
    - Optimize key-value flex row layout in monitor dashboard with hairline dividers
    [artnet_dmx_final.ino]
2026-11-12 docs: synchronize CHANGELOG/README/PRD/REVIEW to v5.2.0 Hardened Production Master
    - CHANGELOG: add v5.1.0 + v5.2.0 entries, update status note to v5.2.0, retitle roadmap to v6.0
    - README: double-buffering -> triple-buffering, roadmap v5.0 -> v6.0, status v5.2.0
    - PRD: version v5.2.0, triple-buffering architecture diagram, ArtPoll/ArtPollReply
    - REVIEW: v5.2.0 refs, add measurement-methodology note (jitter pending FASE 6), fix 44 Hz -> 43.07 Hz
2026-11-12 feat(firmware): align web UI to Obsidian Control Deck design system (v10 parity)
    - Adopt zzluxora-v10 DESIGN.md tokens: obsidian charcoal #1e2024->#242830, cyan #06b6d4, emerald #16a34a, amber #f59e0b, danger #ef4444
    - Replace emoji (wifi/lock glyphs) with inline SVG icons
    - Replace italic 900-weight headings with JetBrains Mono 800 industrial wordmark + sub-badge
    - Status values now render as Linear/Stripe-style soft-tinted pill badges (green/yellow/red/neutral)
    - Add telemetry streaming indicator (pulsing dot) + UNIVERSE 0 badge
    - 5-state interactive contract (default/hover/focus-visible/active/disabled) on all buttons
    - Update Playwright test to match new DOM (uppercase status text, SVG i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
    [artnet_dmx_final.ino]
2026-11-12 Revert "feat(firmware): align web UI to Obsidian Control Deck design system (v10 parity)"
    This reverts commit c76baa7e51b3de91895050703eae31b28580d1e5.
    [artnet_dmx_final.ino]
