zzdevxx/esp32-artnet-dmx/(notices)

Notices in the files:
README.md:
License: Apache-2.0
